NasserTaqi/STM32F0_Multi_Peripheral_PCB/README.md

# STM32F0 Multi Peripheral PCB
This is a PCB project built around an STM32F0 which includes multiple peripherals.

## Components
-	STM32F0 MCU
-	USB C 2.0 connection + ESD protection
-	3.3V power regulator LDO
-	Li-Ion/ Li-Pol battery charger
-	External flash memory
-	GPIO extender
-	Accelerometer + Gyroscope IC
-	Motor Controller IC
-	RGB LED
-	SWD Connector

## Board Setup
It is a 4-layer board with the following stack-up:

Layer: 1	SIGNAL

Layer: 2	GND

Layer: 3	POWER

Layer: 4	SIGNAL

### PCB Schematic:
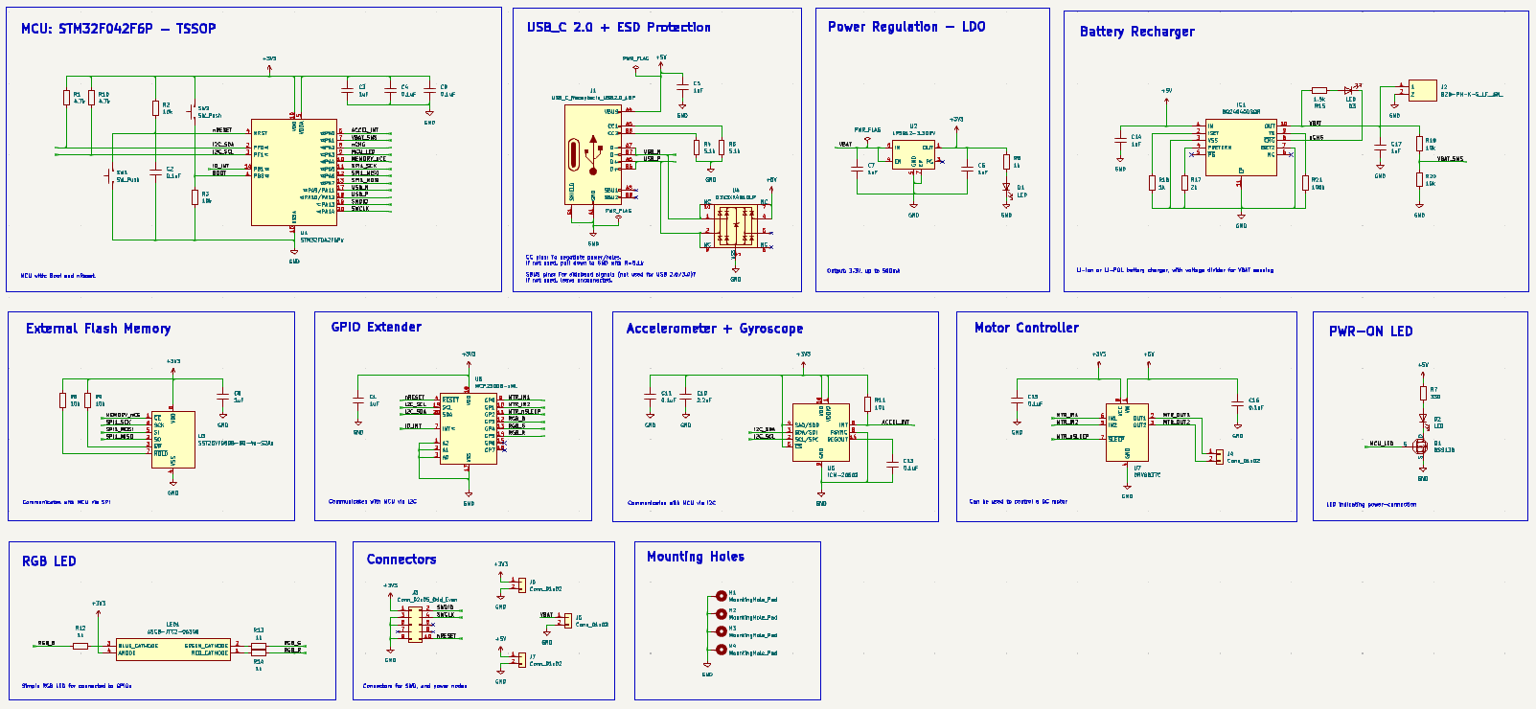
[picture p1: STM32F0_PCB1/PCB_Images/Schematic_Full.png]
image alt


### PCB Layout:
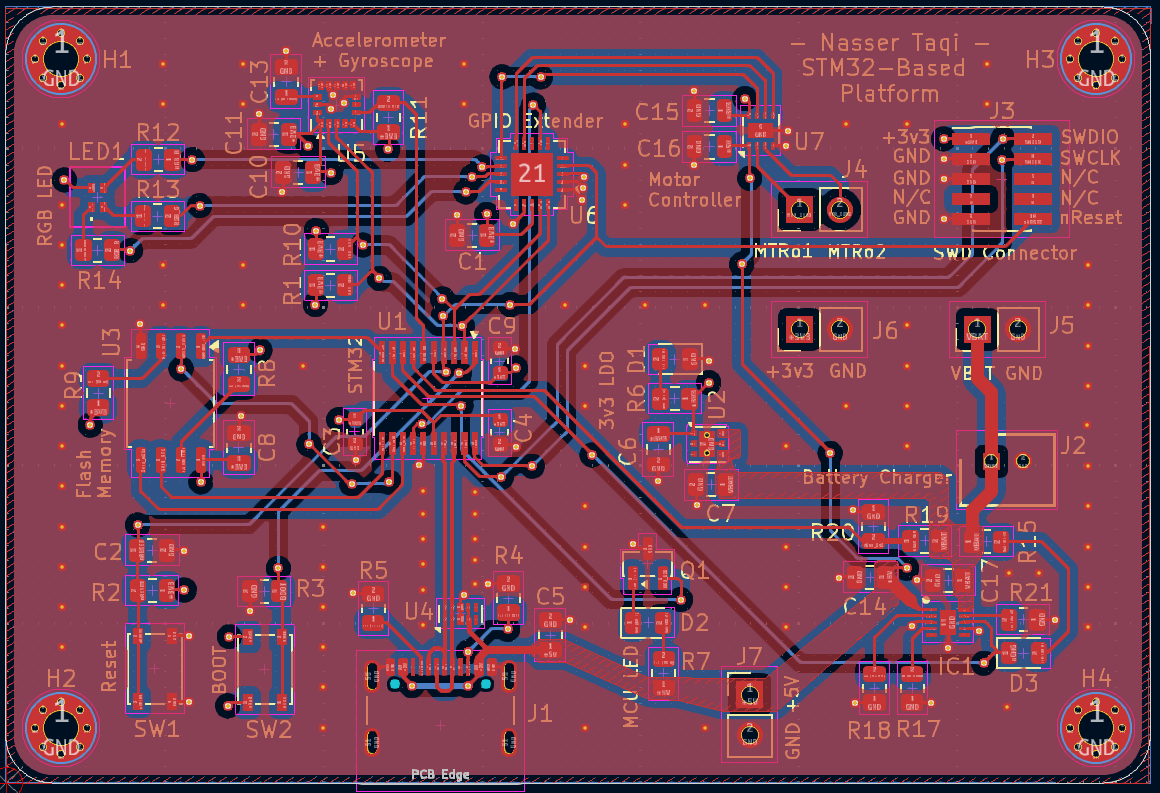
[picture p2: STM32F0_PCB1/PCB_Images/PCB_layout.png]
image alt


### PCB 3D view:
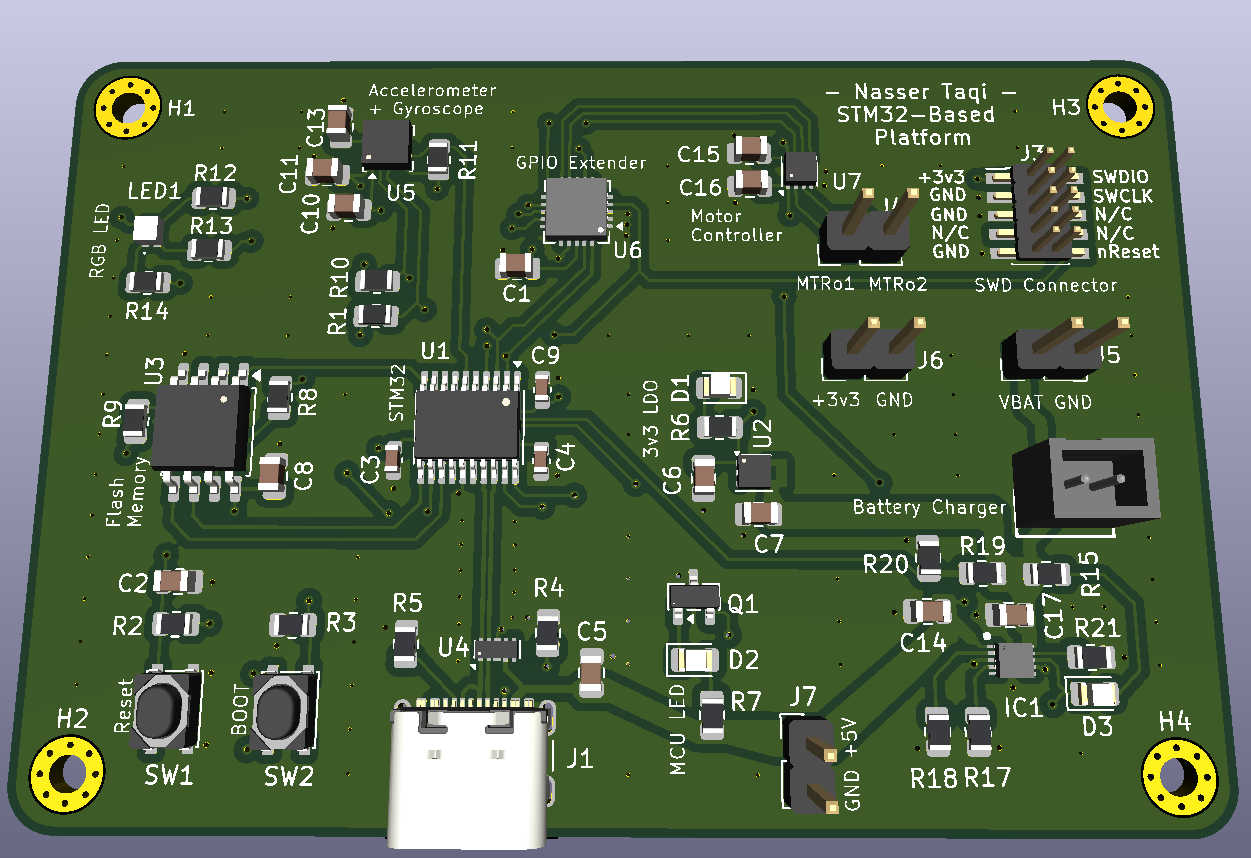
[picture p3: STM32F0_PCB1/PCB_Images/PCB_3D.png]
image alt
