NasserTaqi/STM32F0_Multi_Peripheral_PCB/STM32F0_PCB1/PCB_Images/Schematic_2.png

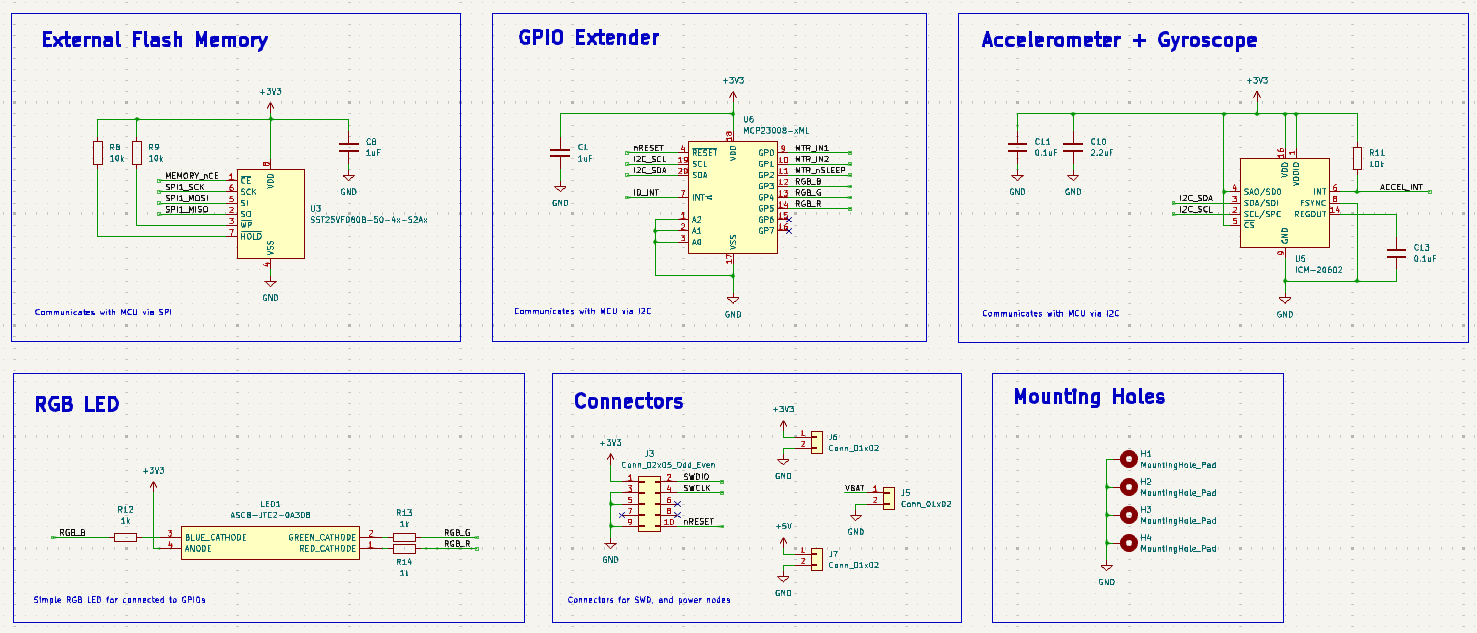
STM32F0_PCB1/PCB_Images/Schematic_2.png
