NasserTaqi/STM32F0_Multi_Peripheral_PCB/STM32F0_PCB1/STM32F0_PCB1.kicad_pcb

## KiCad design STM32F0_PCB1/STM32F0_PCB1.kicad_pcb (2026-05-03)

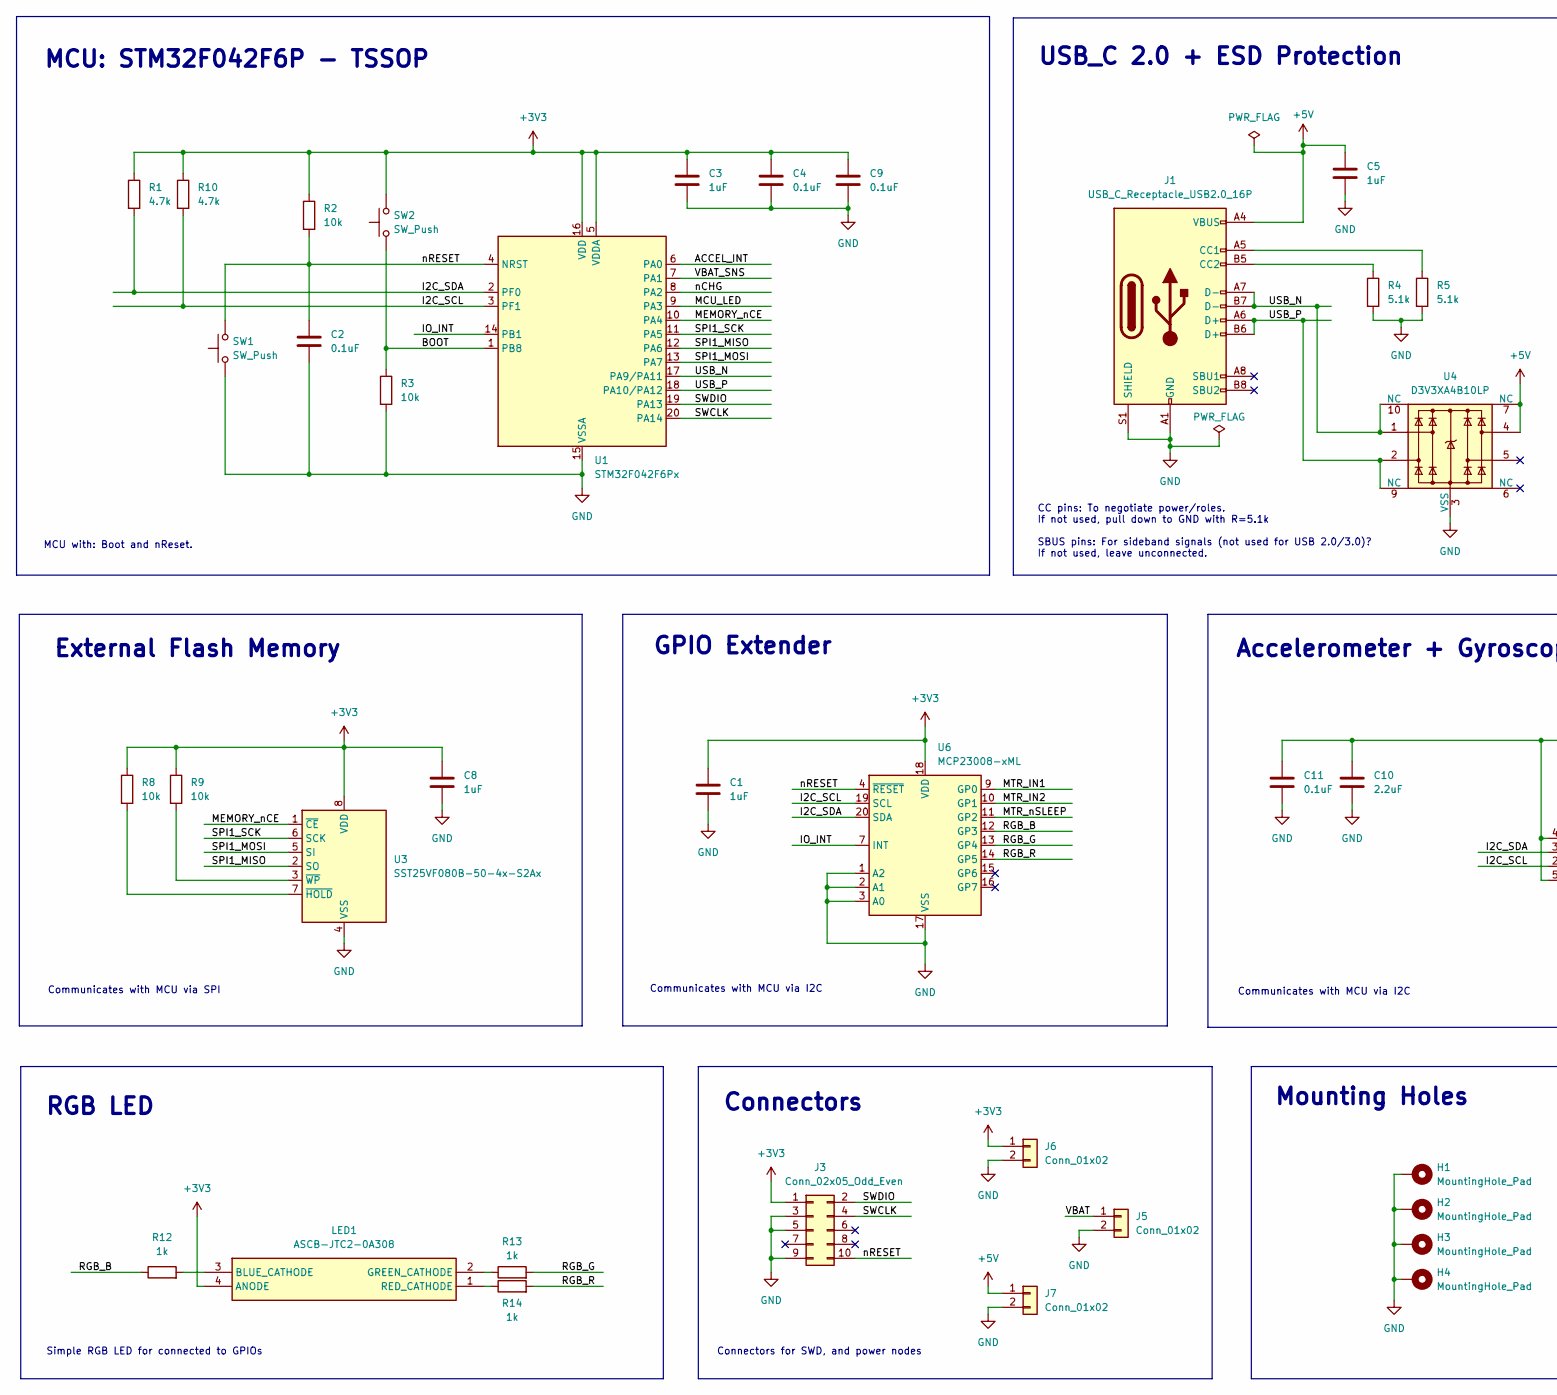
[picture p7: schematic STM32F0_PCB1.kicad_sch, part in row 1, column 1]

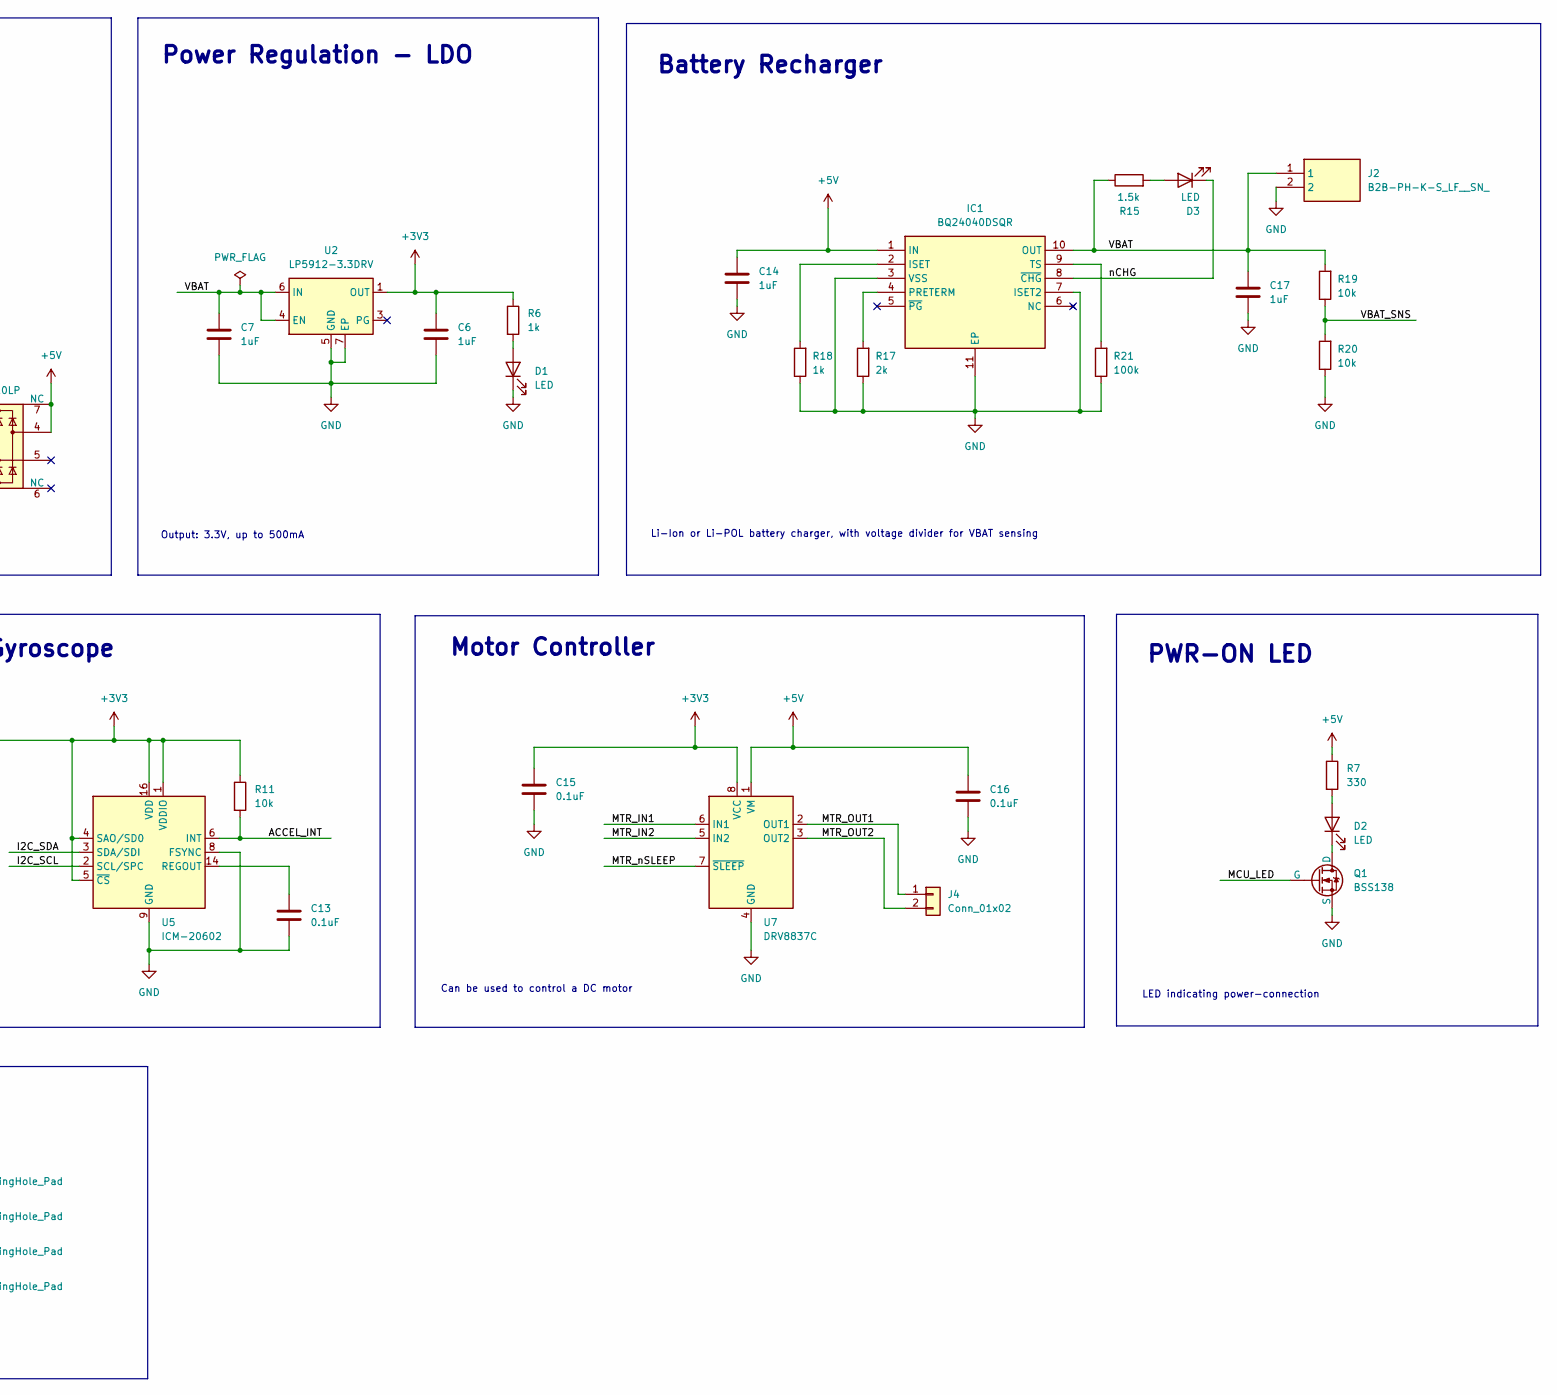
[picture p8: schematic STM32F0_PCB1.kicad_sch, part in row 1, column 2]

Parts:
C1, C5, C6, C7, C8, C14, C17: 1uF; C_0805_2012Metric; Manufacturer Part Number KGM21AR51E105KL
C2, C11, C13, C15, C16: 0.1uF; C_0805_2012Metric; Manufacturer Part Number 885012207098
C3: 1uF; C_0603_1608Metric; Manufacturer Part Number MSASE168SB5105KTNA01
C4, C9: 0.1uF; C_0603_1608Metric; Manufacturer Part Number CC0603JRX7R9BB104
C10: 2.2uF; C_0805_2012Metric; Manufacturer Part Number GXT21BR71C225KE01L
D1, D2, D3: LED; LED_0805_2012Metric; Manufacturer Part Number HSMW-C170-U0000
H1, H2, H3, H4: MountingHole_Pad; MountingHole_2.2mm_M2_Pad_Via
IC1: BQ24040DSQR; SON40P200X200X80-11N; Mouser Part Number 595-BQ24040DSQR
J1: USB_C_Receptacle_USB2.0_16P; USB_C_Receptacle_GCT_USB4105-xx-A_16P_TopMnt_Horizontal; Manufacturer Part Number USB4930-00-A
J2: B2B-PH-K-S_LF__SN_; SHDR2W50P0X200_1X2_590X450X600P; Mouser Part Number 306-B2BPHKSLFSNPP
J3: Conn_02x05_Odd_Even; PinHeader_2x05_P1.27mm_Vertical_SMD; Manufacturer Part Number 10129381-910004BLF
J4, J5, J6, J7: Conn_01x02; PinHeader_1x02_P2.54mm_Vertical; Manufacturer Part Number 826646-2
LED1: ASCB-JTC2-0A308; ASCBJTC20A308; Mouser Part Number 630-ASCB-JTC2-0A308
Q1: BSS138; SOT-23; Manufacturer Part Number BSS138
R1, R10: 4.7k; R_0805_2012Metric; Manufacturer Part Number AC0805JR-134K7L
R2, R3, R8, R9, R11, R19, R20: 10k; R_0805_2012Metric; Manufacturer Part Number RE0805FRE1010KL
R4, R5: 5.1k; R_0805_2012Metric; Manufacturer Part Number RC0805JR-105K1L
R6, R12, R13, R14, R18: 1k; R_0805_2012Metric; Manufacturer Part Number SR0805FR-7W1KL
R7: 330; R_0805_2012Metric; Manufacturer Part Number ERJ-PC6B3300V
R15: 1.5k; R_0805_2012Metric; Manufacturer Part Number AF0805FR-071K5L
R17: 2k; R_0805_2012Metric; Manufacturer Part Number SR0805JR-072KL
R21: 100k; R_0805_2012Metric; Manufacturer Part Number TR0805NR-07100KL
SW1, SW2: SW_Push; SW_SPST_PTS810; Manufacturer Part Number PTS810SJK250SMTR LFS
U1: STM32F042F6Px; TSSOP-20_4.4x6.5mm_P0.65mm; Manufacturer Part Number STM32F042F6P6
U2: LP5912-3.3DRV; WSON-6-1EP_2x2mm_P0.65mm_EP1x1.6mm_ThermalVias; Manufacturer Part Number LP5912-3.3DRVT
U3: SST25VF080B-50-4x-S2Ax; SOIC-8_5.3x5.3mm_P1.27mm; Manufacturer Part Number SST25VF080B-50-4C-S2AF
U4: D3V3XA4B10LP; Diodes_UDFN-10_1.0x2.5mm_P0.5mm; Manufacturer Part Number D3V3XA4B10LP-7
U5: ICM-20602; LGA-16_3x3mm_P0.5mm_LayoutBorder3x5y; Manufacturer Part Number ICM-20602
U6: MCP23008-xML; QFN-20-1EP_4x4mm_P0.5mm_EP2.7x2.7mm; Manufacturer Part Number MCP23008-E/ML
U7: DRV8837C; WSON-8-1EP_2x2mm_P0.5mm_EP0.9x1.6mm; Manufacturer Part Number DRV8837CDSGR

Connections:
+3V3: C1.1, C3.1, C4.1, C6.1, C8.1, C9.1, C10.1, C11.1, C15.1, J3.1, J6.1, LED1.4 (ANODE), R1.1, R2.1, R6.1, R8.1, R9.1, R10.1, R11.1, SW2.2, U1.5 (VDDA), U1.16 (VDD), U2.1 (OUT), U3.8 (VDD), U5.1 (VDDIO), U5.4 (SAO/SD0), U5.5 (~CS), U5.16 (VDD), U6.18 (VDD), U7.8 (VCC)
+5V: C5.1, C14.1, C16.1, IC1.1 (IN), J1.A4 (VBUS), J1.A9 (VBUS), J1.B4 (VBUS), J1.B9 (VBUS), J7.1, R7.1, U4.4, U4.7 (NC), U7.1 (VM)
/ACCEL_INT: R11.2, U1.6 (PA0), U5.6 (INT)
/BOOT: R3.1, SW2.1, U1.1 (PB8)
/I2C_SCL: R10.2, U1.3 (PF1), U5.2 (SCL/SPC), U6.19 (SCL)
/I2C_SDA: R1.2, U1.2 (PF0), U5.3 (SDA/SDI), U6.20 (SDA)
/IO_INT: U1.14 (PB1), U6.7 (INT)
/MCU_LED: Q1.2 (G), U1.9 (PA3)
/MEMORY_nCE: U1.10 (PA4), U3.1 (~CE)
/MTR_IN1: U6.9 (GP0), U7.6 (IN1)
/MTR_IN2: U6.10 (GP1), U7.5 (IN2)
/MTR_OUT1: J4.1, U7.2 (OUT1)
/MTR_OUT2: J4.2, U7.3 (OUT2)
/MTR_nSLEEP: U6.11 (GP2), U7.7 (~SLEEP)
/RGB_B: R12.1, U6.12 (GP3)
/RGB_G: R13.2, U6.13 (GP4)
/RGB_R: R14.2, U6.14 (GP5)
/SPI1_MISO: U1.12 (PA6), U3.2 (SO)
/SPI1_MOSI: U1.13 (PA7), U3.5 (SI)
/SPI1_SCK: U1.11 (PA5), U3.6 (SCK)
/SWCLK: J3.4, U1.20 (PA14)
/SWDIO: J3.2, U1.19 (PA13)
/USB_N: J1.A7 (D-), J1.B7 (D-), U1.17 (PA9/PA11), U4.1, U4.10 (NC)
/USB_P: J1.A6 (D+), J1.B6 (D+), U1.18 (PA10/PA12), U4.2, U4.9 (NC)
/VBAT: C7.1, C17.1, IC1.10 (OUT), J2.1, J5.1, R15.1, R19.2, U2.4 (EN), U2.6 (IN)
/VBAT_SNS: R19.1, R20.2, U1.7 (PA1)
/nCHG: D3.1 (K), IC1.8 (~CHG), U1.8 (PA2)
/nRESET: C2.1, J3.10, R2.2, SW1.2, U1.4 (NRST), U6.4 (~RESET)
GND: C1.2, C2.2, C3.2, C4.2, C5.2, C6.2, C7.2, C8.2, C9.2, C10.2, C11.2, C13.2, C14.2, C15.2, C16.2, C17.2, D1.1 (K), H1.1, H2.1, H3.1, H4.1, IC1.3 (VSS), IC1.7 (ISET2), IC1.11 (EP), J1.A1 (GND), J1.A12 (GND), J1.B1 (GND), J1.B12 (GND), J1.S1 (SHIELD), J2.2, J3.3, J3.5, J3.9, J5.2, J6.2, J7.2, Q1.3 (S), R3.2, R4.2, R5.2, R17.1, R18.1, R20.1, R21.1, SW1.1, U1.15 (VSSA), U2.5 (GND), U2.7 (EP), U3.4 (VSS), U4.3 (VSS), U4.8 (VSS), U5.8 (FSYNC), U5.9 (GND), U5.10 (GND), U5.11 (GND), U5.12 (GND), U5.13 (GND), U5.15 (GND), U6.1 (A2), U6.2 (A1), U6.3 (A0), U6.17 (VSS), U7.4 (GND), U7.9 (GND)
unnamed: D1.2 (A), R6.2
unnamed: D2.2 (A), R7.2
unnamed: D2.1 (K), Q1.1 (D)
unnamed: D3.2 (A), R15.2
unnamed: IC1.2 (ISET), R18.2
unnamed: IC1.4 (PRETERM), R17.2
unnamed: IC1.9 (TS), R21.2
unnamed: J1.A5 (CC1), R5.1
unnamed: J1.B5 (CC2), R4.1
unnamed: LED1.3 (BLUE_CATHODE), R12.2
unnamed: LED1.2 (GREEN_CATHODE), R13.1
unnamed: LED1.1 (RED_CATHODE), R14.1
unnamed: R8.2, U3.7 (~HOLD)
unnamed: R9.2, U3.3 (~WP)
unnamed: C13.1, U5.14 (REGOUT)

Notes on the sheet:
Power Regulation - LDO
Communicates with MCU via I2C
CC pins: To negotiate power/roles. If not used, pull down to GND with R=5.1k SBUS pins: For sideband signals (not used for USB 2.0/3.0)? If not used, leave unconnected.
USB_C 2.0 + ESD Protection
Communicates with MCU via SPI
MCU: STM32F042F6P - TSSOP
GPIO Extender
LED indicating power-connection
RGB LED
Can be used to control a DC motor
Output: 3.3V, up to 500mA
Motor Controller
Simple RGB LED for connected to GPIOs
PWR-ON LED
Li-Ion or Li-POL battery charger, with voltage divider for VBAT sensing
Accelerometer + Gyroscope
External Flash Memory
Battery Recharger
Mounting Holes
Connectors
MCU with: Boot and nReset.
Connectors for SWD, and power nodes

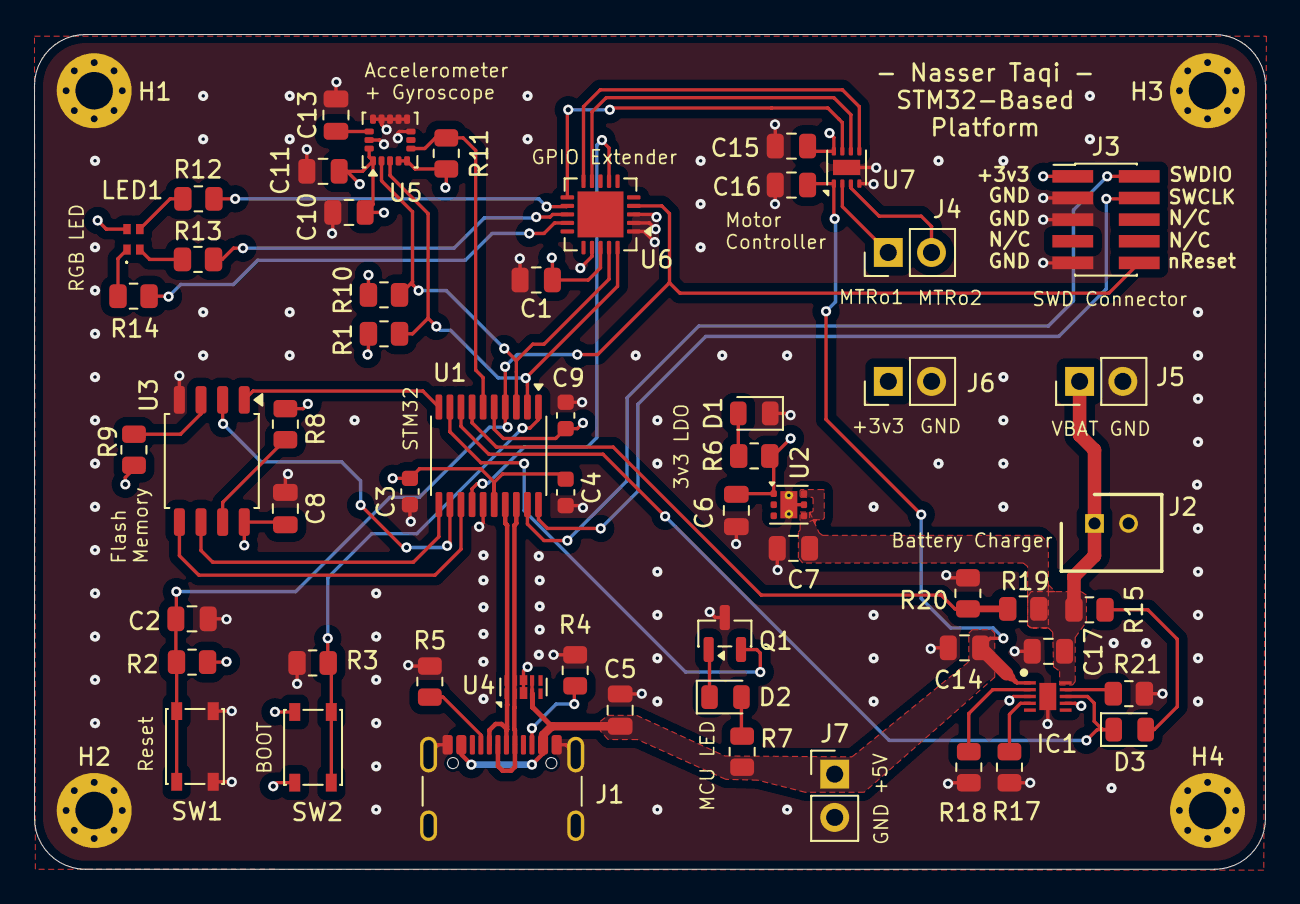
[picture p9: board STM32F0_PCB1.kicad_pcb from above]

Board: 4 copper layers, 72.3 x 49.0 mm, 62 parts (0 on the bottom side), 44 nets.
